logan-dubuisson/TheWorkoutBuddy/website/assets/location-1.png

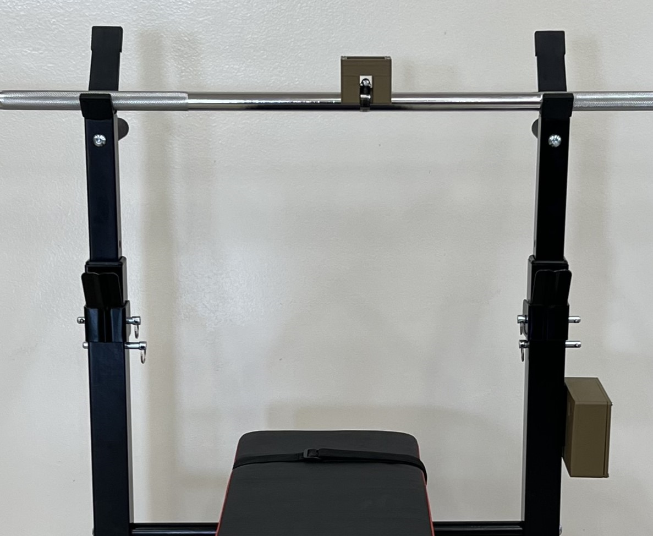
website/assets/location-1.png
