logan-dubuisson/TheWorkoutBuddy/website/assets/house-1.png

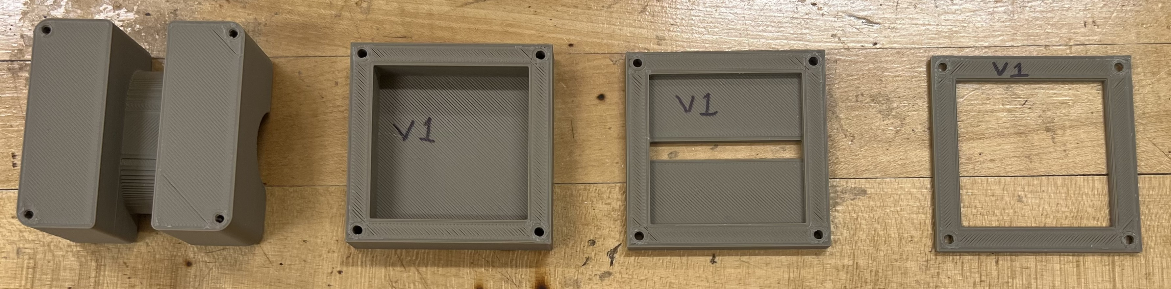
website/assets/house-1.png
