logan-dubuisson/TheWorkoutBuddy/README.md

# TheWorkoutBuddy
Bravo Builders Senior Design Project
