logan-dubuisson/TheWorkoutBuddy/website/assets/About-pic.png

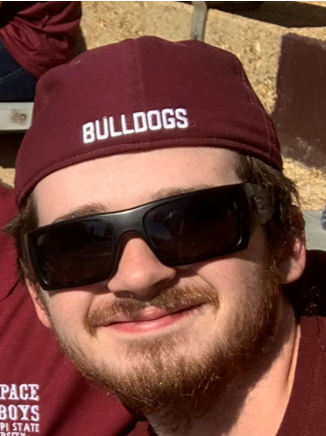
website/assets/About-pic.png
