logan-dubuisson/TheWorkoutBuddy/website/assets/austin-pic.png

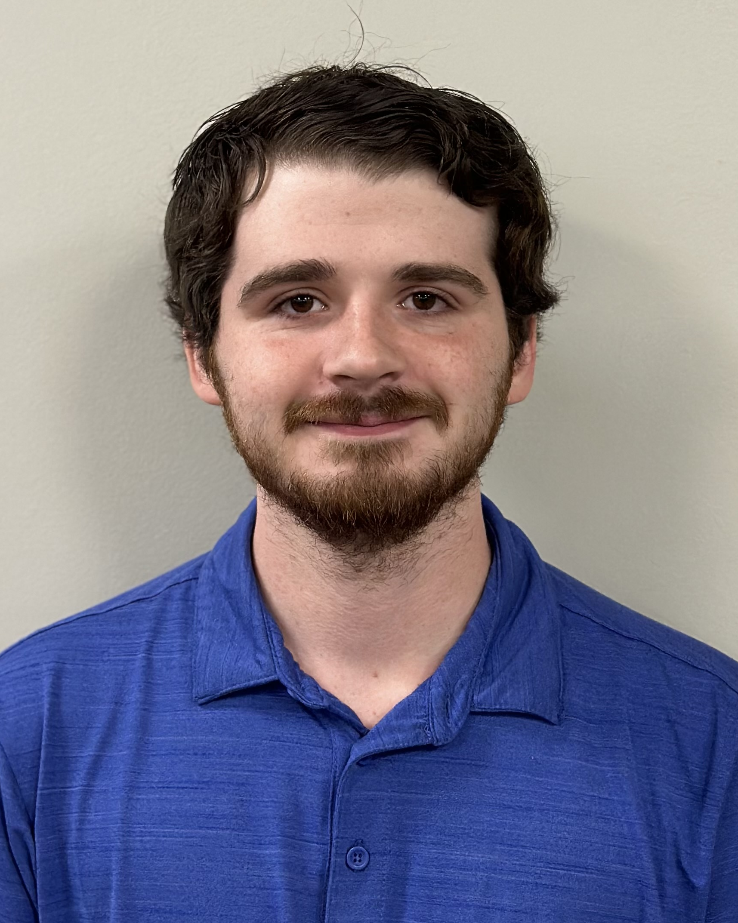
website/assets/austin-pic.png
