logan-dubuisson/TheWorkoutBuddy/website/assets/david-pic.png

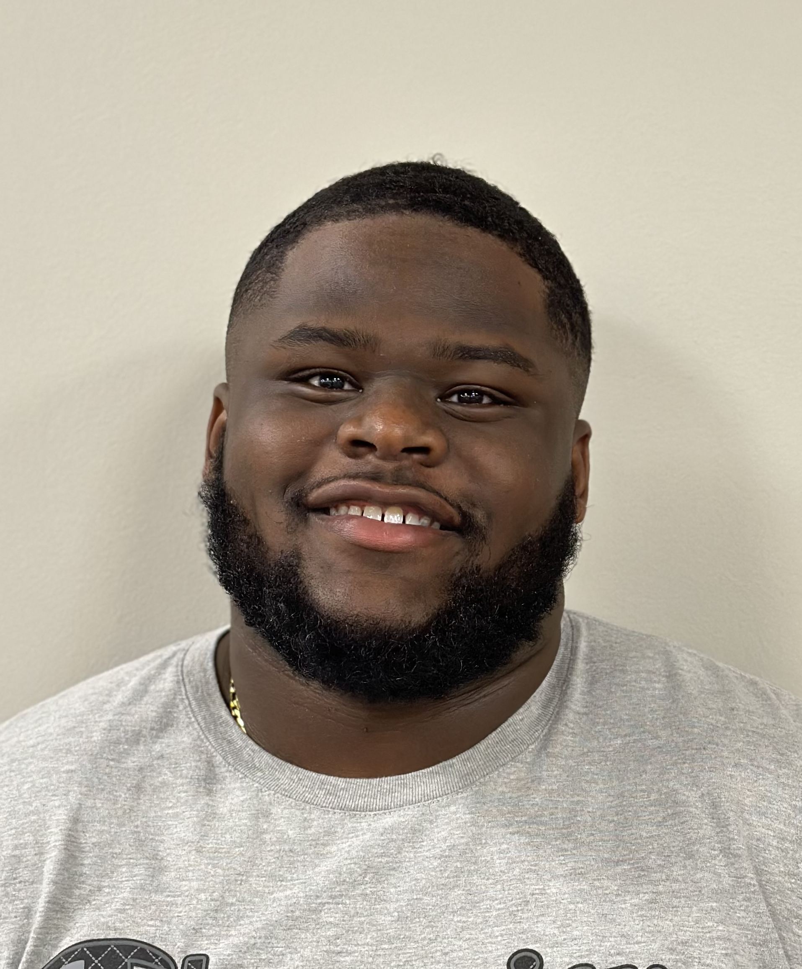
website/assets/david-pic.png
