logan-dubuisson/TheWorkoutBuddy/website/assets/epic-photo.png

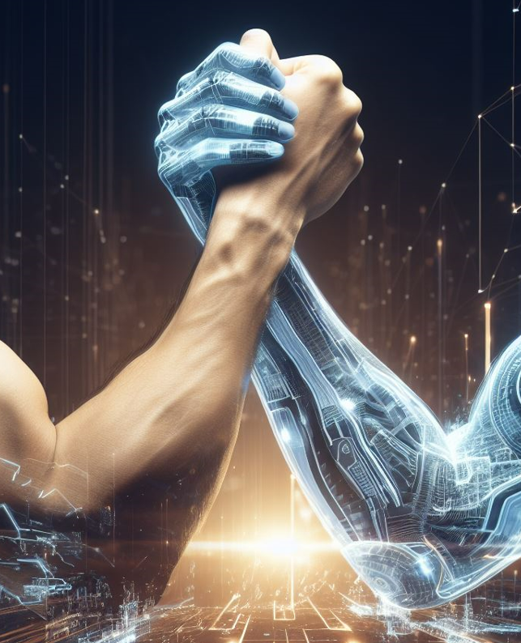
website/assets/epic-photo.png
