logan-dubuisson/TheWorkoutBuddy/website/assets/IMG_6887.png

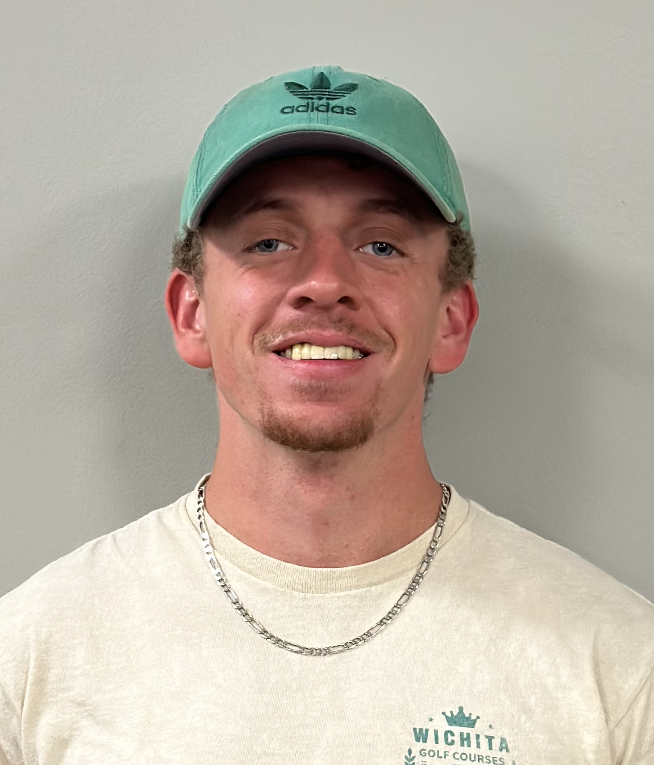
website/assets/IMG_6887.png
