logan-dubuisson/TheWorkoutBuddy/website/assets/location-2.png

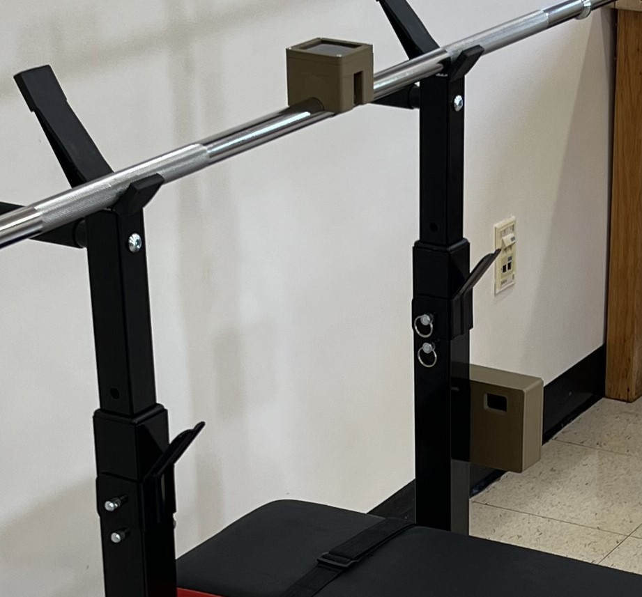
website/assets/location-2.png
