logan-dubuisson/TheWorkoutBuddy/website/assets/logan-pic.png

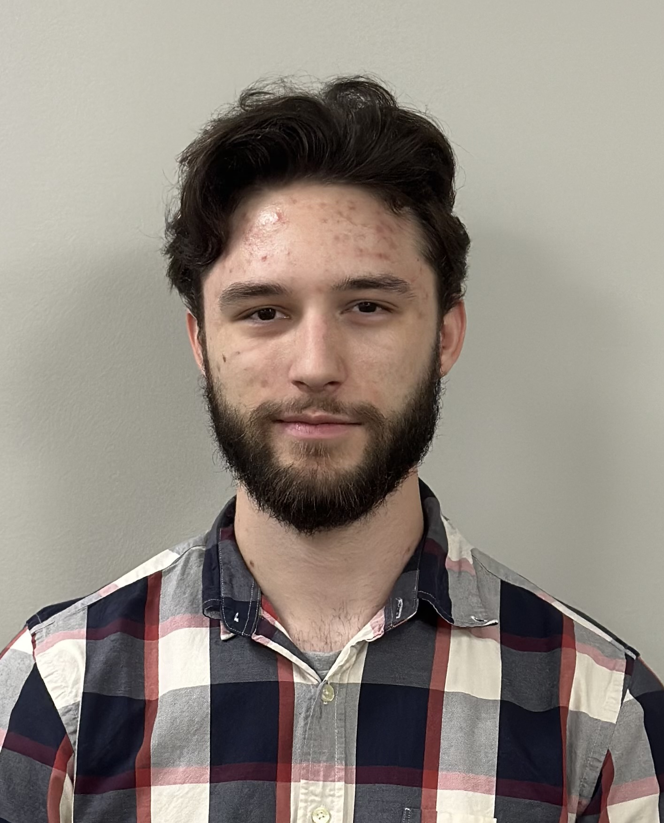
website/assets/logan-pic.png
