logan-dubuisson/TheWorkoutBuddy/website/assets/marlon-pic.png

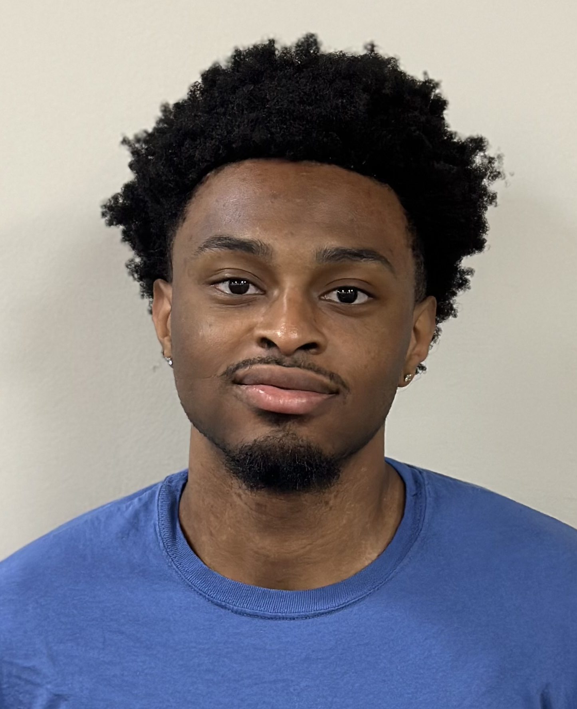
website/assets/marlon-pic.png
