logan-dubuisson/TheWorkoutBuddy/website/assets/profile-pic-1.jpg

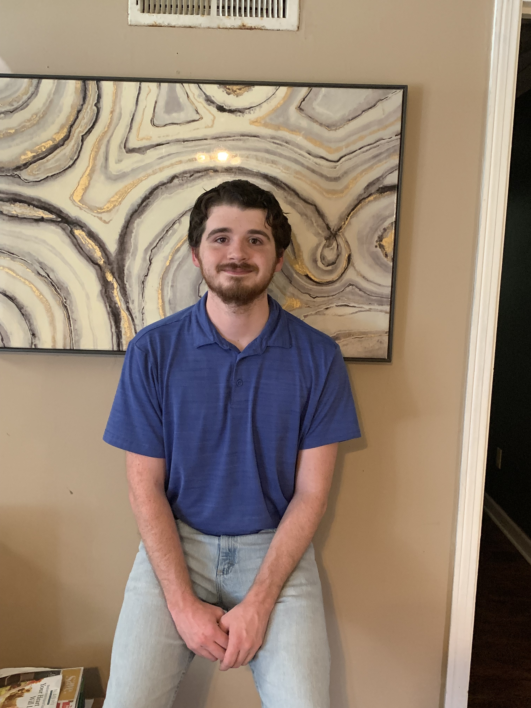
website/assets/profile-pic-1.jpg
