logan-dubuisson/TheWorkoutBuddy/website/assets/profile-pic-2.png

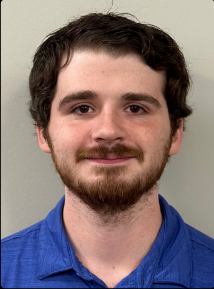
website/assets/profile-pic-2.png
