logan-dubuisson/TheWorkoutBuddy/website/assets/profile-pic-3.png

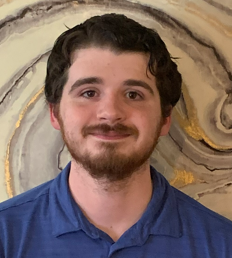
website/assets/profile-pic-3.png
