logan-dubuisson/TheWorkoutBuddy/website/assets/Project-1.png

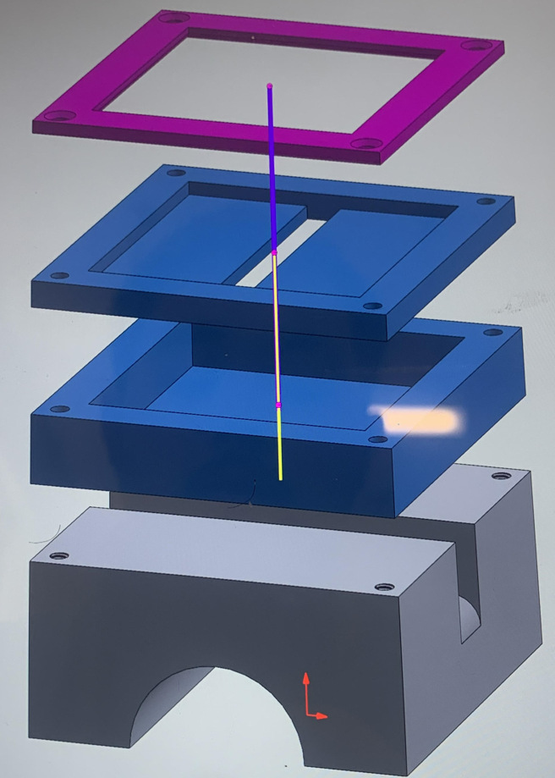
website/assets/Project-1.png
