logan-dubuisson/TheWorkoutBuddy/website/assets/teacher-1.png

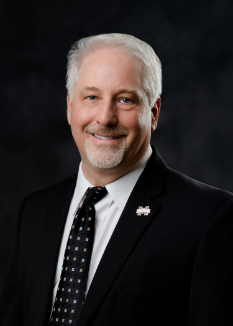
website/assets/teacher-1.png
