logan-dubuisson/TheWorkoutBuddy/website/assets/teacher-2.png

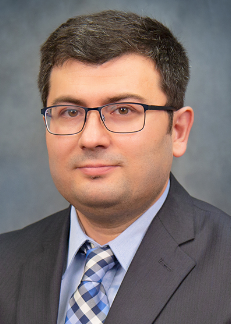
website/assets/teacher-2.png
